RonAaron61/EIT-Microcontroller/assets/image/PCB_2D.png

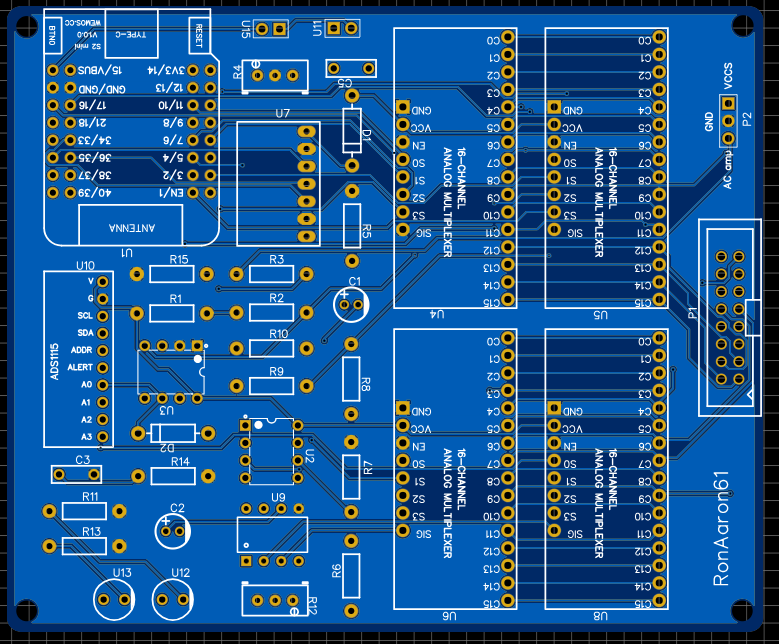
assets/image/PCB_2D.png
