RonAaron61/EIT-Microcontroller/assets/image/Result_Prototype_1/Result_3_30K.png

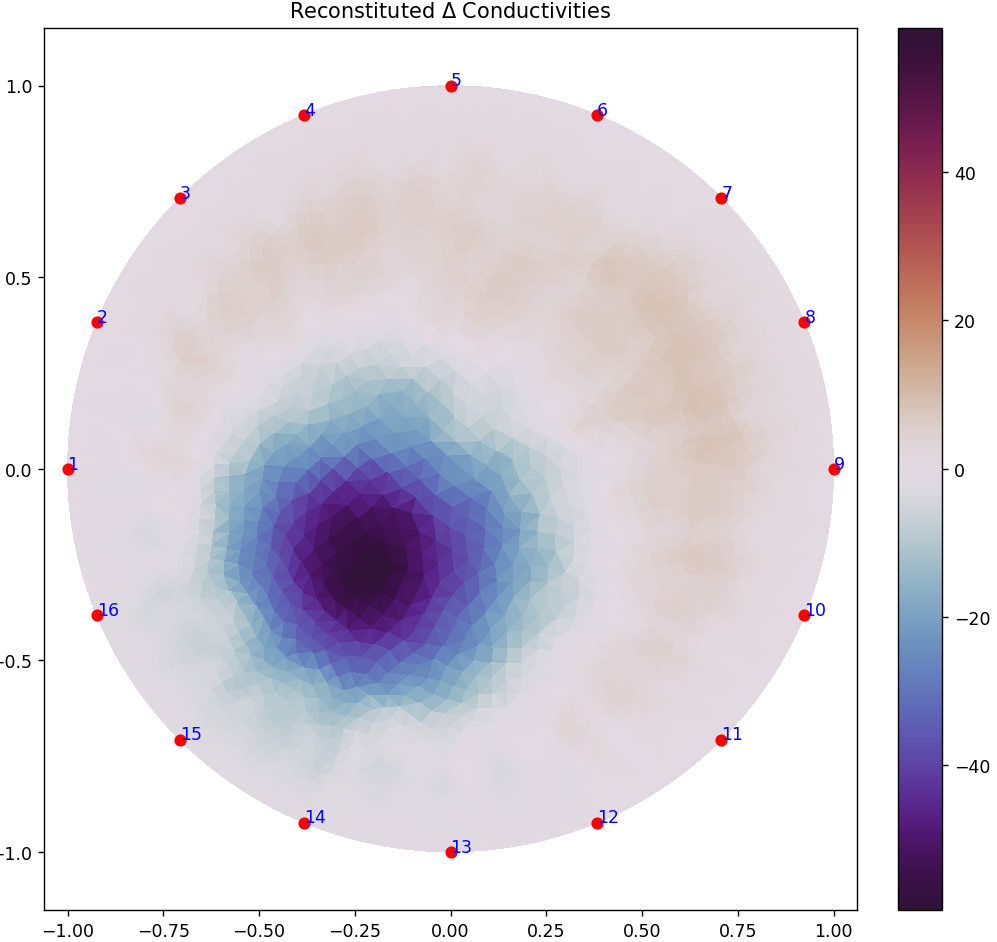
assets/image/Result_Prototype_1/Result_3_30K.png
