RonAaron61/EIT-Microcontroller/assets/image/Result_Prototype_1/Result_5_30K.png

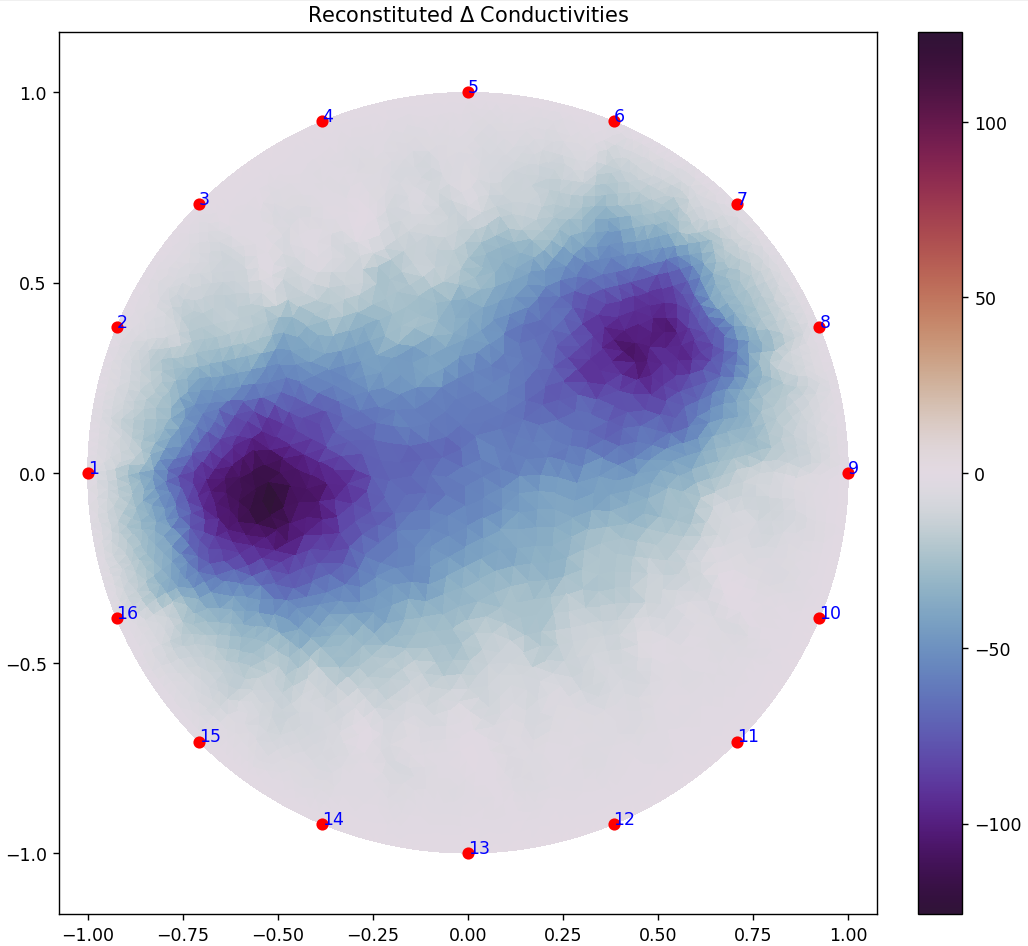
assets/image/Result_Prototype_1/Result_5_30K.png
