RonAaron61/EIT-Microcontroller/assets/image/Result_Prototype_1/Spidol_Elect 4-5_30k.png

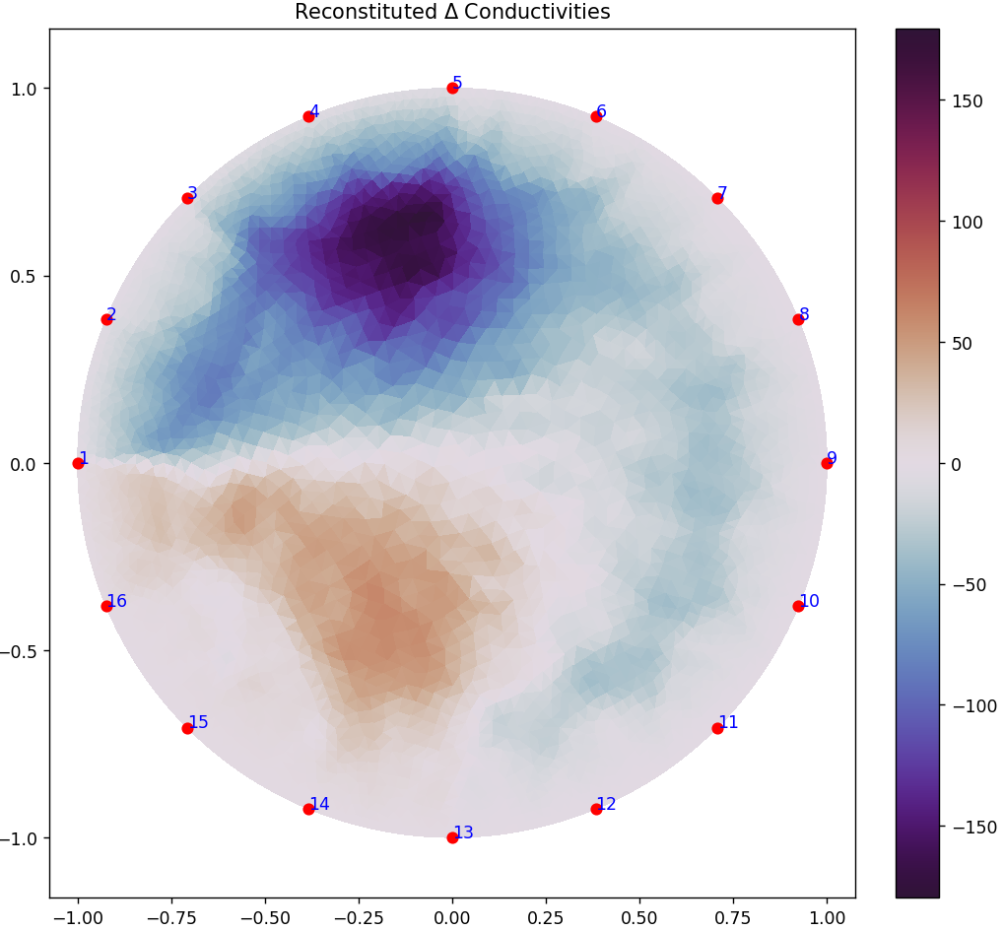
assets/image/Result_Prototype_1/Spidol_Elect 4-5_30k.png
