RonAaron61/EIT-Microcontroller/(threads)

Thread 1 (2024-05-28):

Request for Guidance on ESP32 S2 Microcontroller-Based Electrical Impedance Tomography Device

popular1119, 2024-05-28:
Dear RonAaron61,

I hope this message finds you well.

My name is Peng Piao, and I have been deeply inspired by your project on the ESP32 S2 microcontroller-based Electrical Impedance Tomography (EIT) device. I have thoroughly reviewed the materials and documentation you have shared on GitHub and am truly impressed by the innovation and technical expertise demonstrated in your work.

As someone who is passionate about electronics and microcontroller-based projects, I am particularly interested in understanding the thought process and methodology behind your project. While the documentation provides a comprehensive overview of the implementation, I am eager to learn more about the challenges you faced, the decisions you made, and the techniques you employed during the development of this device.

I would be immensely grateful if you could spare some time to share your insights and experiences with me. Specifically, I am interested in discussing:
1. The initial conceptualization and design phase of the project.
2. The selection process for the ESP32 S2 microcontroller and other key components.
3. Any significant challenges or obstacles you encountered and how you overcame them.
4. Best practices and tips for someone looking to embark on a similar project.

I believe that your guidance would be invaluable in helping me gain a deeper understanding of EIT technology and its practical applications. I am eager to learn from your experience and apply this knowledge to my own projects.

Thank you very much for considering my request. I look forward to the possibility of connecting with you and learning from your expertise.

Best regards,

Peng Piao
pengpiao1119@gmail.com

RonAaron61, 2024-05-28:
Hello Peng Piao,

I'm happy to have someone interested in my project.

First of all, about the conceptualization of the design, I got the concept because my undergraduate thesis is also about EIT, so I got the abstract design and the main concept of how it works from my lectures and other papers. Then I modified and implemented it on this project.

The reason why I chose the ESP is that it’s relatively cheap and has many pinouts. Because based on my design, it required at least 16 pins for the demultiplexer/multiplexer and another 5 pins for the AD9833 and ADS1115 modules, the integrated wifi module can also be useful if you want to make it wireless. For the other components, I looked for papers related to EIT and analyzed what type of components they used, so that I could use them.

After finding what components are suitable for my project then I can make a prototype of each circuit/component to see if it actually work. Then it can be combined into one functional protoype. At this time is when you need to solve any challenges, especially because when prototyping I used a proto-board and jumper wires, which made it look stressful, that is why I suggested making them one by one. Always double-check for the wire and pin connection, especially if it’s related to supply, the type of the IC may also affect the result. Also sometimes the problem is the one you least expect it.

I think it’s best to look for multiple papers/journals about EIT and see what components they use and try it by yourself, to find which is the most suitable for the project.

I'm welcome for related questions, but I may not be good at explaining, because I’m not really an expert in this field.

I hope this answers most of your questions,

Best,

Aaron

popular1119, 2024-05-29:
Hi Aaron,

Thank you very much for your previous response. I have a few more questions that I hope you can help me with:

Firstly, due to the geographical difference between us, there might be a time difference. Therefore, I may not be able to respond to your messages promptly, and I appreciate your understanding.

1. Purpose and Published Articles: Could you please share what your ESP32 S2 Electrical Impedance Tomography (EIT) device is primarily used to measure? Additionally, have you published any articles or papers about this device? If so, I would love to read them.

2. Lung Monitoring: Is your EIT device used for lung respiration monitoring? I have an EIT device here, but it does not work properly when used for lung respiration monitoring. Therefore, I hope to understand some relevant details.

3. Microcontroller and Chip Communication: I would like to learn more about the control and communication between microcontrollers and other chips. Although I use many devices, I do not know much about their internal principles. Do you have any recommended courses or resources that can help me better understand this area?

Thank you very much for your time and assistance. I look forward to your response.

Best regards,
Peng Piao
pengpiao1119@gmail.com

RonAaron61, 2024-05-29:
For now, I only use my project device for measuring objects (eq. plastic or metal) on the water solution phantom, like one of the images on the GitHub page. But maybe later I also want to test if it can detect anomalies (eq. cancer) in objects that have the same impedance as the human body, I have tried to make an agar phantom in my previous undergraduate project using the reference from [Bennet D. (2010)]( http://dx.doi.org/10.1016/j.msec.2010.08.018). But I also want to improve my device because I don’t know why, but when I tried to scan an object in the middle of the phantom it doesn’t show great.  For now, I haven’t published a paper or articles related to this project.

That is an interesting Idea to use it as a lung monitoring device. But I haven’t tried it to scan on the thorax area. Maybe it is related to the current being injected or the frequency being used? Because from what I know higher freq eq. ≥ 50kHz is more able to penetrate cells (?).

To be honest, I also don’t really know how the principles of the chip work, I only know how to use it and maybe some of the specifications based on its datasheet. If we speak maybe like the modules that I used, I think you can just search online on its pinout, and how to connect and code it to the microcontroller, I think there is a lot of websites or videos explaining it because most of it is open-source. Some of the modules used either I2C or SPI communication protocol, maybe you can look at it while trying the module itself.
When I find some interesting modules or IC I usually just search what is the pinouts and how to use them online, and then tried it myself.

Hope this help

Best,
Aaron

RonAaron61, 2024-05-30:
Hi Peng Piao,

I would say that it's not 100% guaranted, but building it one module at a time then gradually start adding another components while check if it still working can minimize the error, whilst if you doing it all at once, it would be difficult to identify which one is the problem, because you have to prob each pins to analyze it.

During the integration process because I usually use a project board with lots of jumper cables, maybe you can try simplify the cable connections so it doesn't get confusing or label the important cables like the output / input, because let say you have a break from the project for a couple of day, you would still know which cables is which. Also check the component specifications, because it is possible that the output of that component exceeds the input specifications of the next connected component, especially when dealing with gain. but I think because all components are connected to the same supply voltage, the possibility of this is low.

One of the most important things is to check what kind of output or input the component requires.

Then you also need to be careful when combining the coding of several modules into one final program.

Hope this help
Best,
Aaron

popular1119, 2024-05-30:
Dear Aaron,

I sincerely appreciate your patient responses. They have been incredibly helpful to me.

Moving forward, I will begin working on creating the Electrical Impedance Tomography (EIT) device. As I proceed, I hope to be able to reach out to you for guidance if I encounter any issues.

Thank you once again for your support!

Best regards,

Peng Piao

RonAaron61, 2024-05-30:
Hi Peng Piao

Of course, anytime, I am happy to help. I hope your project goes as smoothly as you planned. Goodluck

Best Regards,
Aaron

Thread 2 (2024-07-04):

Assistance Required for EIT Boundary Voltage Signal Processing and Frame Rate Improvement

popular1119, 2024-07-04:
Hi Aaron,

I hope this message finds you well. I have a couple of technical questions regarding electrical impedance tomography (EIT) that I hope you can help with.

First, after the boundary voltage analog signal is selected through the multiplexer and amplified, it is sent to the analog-to-digital converter (ADC). Is there any special processing, aside from filtering, that needs to be done to the boundary voltage analog signal before converting it to a digital signal? Or can we directly convert the analog signal to a digital signal and then send it to the microcontroller for further conversion back to an analog signal without any special processing?

Additionally, I am looking to improve the acquisition rate to around 100 frames per second. Could you please advise on the best approach to achieve this?

Thank you very much for your help!

Best regards,
Peng Piao

RonAaron61, 2024-07-05:
Hi Peng Piao,

Hmm, I’m assuming that you want to read the Max/rms voltage, if so based on my previous project I think you should check the capability of your ADC first because if you directly input an analog AC signal into the ADC it may destroy the module, because the ADC may not be capable of reading a negative voltage, and even if the ADC can read negative voltage I think the readout may fluctuate between the max voltage and min voltage (assumed the signal is an AC signal). I think you can change the AC signal to a DC signal first then connect it to your ADC.

As for the acquisition rate, I also don't really know about this, but I think it is related to the controller's processing speed and how well/optimized the code is written.

Hope this help

Best regards,
Aaron

popular1119, 2024-07-06:
Aaron,

I'm not sure why, but the sine wave signal output from my AD9833 measures at an amplitude of 6V. I tried using the AD8421 and the programmable AD5270 to adjust the amplitude, but it had no effect and instead caused the waveform to become distorted.

Thanks!

Peng Piao

popular1119, 2024-07-06:
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
The first one is the waveform directly output by AD9833, and the second photo is after adjustment.

RonAaron61, 2024-07-06:
Hi Peng Piao,

Hmm, that's interesting, from what I read the output of AD9833 usually maxs at around 600mV, isn't the sine wave around 2.12Vpp in the image?, and so the problem is when you want to change the amplitude from the AD9833 it becomes distorted. I assumed you connected the output of AD9833 directly into AD8421 (which is an instrument amplifier) and controlled the gain using AD5270 (is it a digital potentiometer?). I never use AD8421 but I think it is similar to what I used before which is AD620. Do you connect the output of AD9833 to the Positive input of AD8421 and the Negative input & REF to GND? or do you have another configuration? because an Instrument amplifier amplifies the difference between the negative and positive input. Or maybe try adding a buffer between the output of AD9833 and AD8421 (?)
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
another alternative is using a non-inverting amplifier to amplify the signal

Aaron

popular1119, 2024-07-08:
Hi Aaron，

I checked the relevant information and found that the output of AD9833 is between 0.4~0.6V. I don’t know why it is so high here.

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

Peng Piao

RonAaron61, 2024-07-09:
Hi Peng Piao,

Have you found a solution to it? I have tried to make a similar circuit but for the Instrument amplifier I used AD620 and regular trimpot, and the result was also not very great, but my AD9833 output is only around 0.5V either with 3.3V or 5V, and I don’t really know what caused the output to be so high.

As for the Instrument amplifier output, I've tried fiddling with the circuit like offsetting the input and -IN by 2.5V (the same with ref), adding buffer, changing the Instrument Amplifier by a non-inverting amp (single rail supply), etc. and it still doesn't work, but you may try messing with it maybe it somehow works on yours. My only answer for now is to try to use a dual rail supply (eq. +5V and -5V) on the Instrument amplifier.

Aaron

popular1119, 2024-07-11:
Hi Aaron,

I still don't know why, so I'm going to buy a new AD9833 module and try it again.

Peng Piao

popular1119, 2024-08-02:
Hi Aaron,

Long time no contact, hope everything is well. I read your code today. It seems that your code directly reads the collected voltage value without any additional operations, because I saw that some people seem to calculate the amplitude and average of the read voltage value. Square root and phase. Your code does not operate in this way, which means that the voltage value read directly can be used for imaging, right?

Peng Piao

RonAaron61, 2024-08-27:
Hello Peng Piao,

I'm so sorry for the long response. I'm doing well just been a busy month, I hope everything went well with you also.

Yeah, I directly use the voltage value from the ADC (that I later knew somehow my ADC value offset by around 17%). I initially wanted to read the phase but I think I need another module to read it. As for the other like average and square root or maybe square mean root (rms) I think the result would be similar, maybe reading the average would remove some of the noise (?). And also the reason why I don't do any processing is to speed up the reconstruction and gathering data. Maybe you can experiment with it to see which method can result the best within the desired time.

Best Regards,
Aaron

Thread 3 (2025-03-11):

Request for Guidance on the Signal captured by the EIT device using ESP32 S3 Dev Kit

mrana47, 2025-03-11:
Dear Aaron,
I hope this email finds you well.

I have been following your ESP32 S2 Electrical Impedance Tomography (EIT) project on GitHub with great interest. I saw you video and circuits that are truly inspiring. I am also working on the same module. I followed your circuit. I divided the circuit into two part. One is before adding MUX and rest.
I found that after applying 30 kHz sine signal in AD9833, I am getting correct signal. Then add the four MUX to build the complete circuit. After finishing the circuit. I made the following phantom setup. But I am not getting the signal you got as a homogenous sample. Could you please help me regarding this. Is there anything wrong in the setup. I made the circuit exactly same you made, only difference is that I used ESP32 S3 Dev kit instead of  WEMOS S2 Mini.
I have add the pictures.

Thanks
Masud

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

RonAaron61, 2025-03-12:
Hello Masud,

Thank you for the message. I see. Does the 30 kHz that you read after the AD9833 or after the amplifier/VCCS? Can you try reading the signal on the 'one before adding MUX' circuit like the image below? If all the signals are good, then I can say that the circuit is good, and the power is also running, especially the positive and negative voltage (because that was also my problem when starting this project). Or you can do it with the MUX circuit.

I'm thinking of one of this may be your problem based on my experience:
- The positive and Negative voltage is not stable ( it should be at least +3.3V and -3.3V so that the IC is running).
- What type of IC are you using, some OP-Amp ICs can't handle high-frequency
- and also check if each component/IC/module is working
- Because you're using a different ESP, are the pins on the correct pins?
- Try to do a calibration first:
  1. Set the MUX to one pin (or like the calibrate button)
  2. Try reading the signal before it goes to the MUX and Phantom (after the VCCS) if the amplifier is too high the signal may collapse because is higher than the input voltage of the IC
  3.  Then also try reading the signal after the Phantom Mux, it should be on the same frequency as the input
  4. Check the output of the Instrument Amplifier, same as VCCS, if the Gain is too High the signal may also collapse, try moving the potentiometer to the Minimum/max to see the range
  5. Lastly if all check out, It may be because of the AC to DC reading

- try using a resistor first like the image below just to make sure,
- It could also just be the bad cable or some IC not working, this also happened to me sometimes

Also in this project to get the negative voltage I used the voltage divider but it requires you to input a voltage twice the voltage you need, you could also use a positive-to-negative module and connect it to the input voltage of the ESP (the BUS pin) so you don't need additional power input. I use this on the next version of this project, although it doesn't improve much besides a more compact size, Link: https://github.com/RonAaron61/MyEIT-V1.1

Hope this message helpful

Best regards,
Aaron

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

mrana47, 2025-03-14:
Dear Aaron,
Thank you very much for your reply. I saw your new project. I want to build that project. I just wondering, can you please share the component that you used to make.

Best Regards
Masud

RonAaron61, 2025-03-17:
Hello Masud,
it basically has the same circuit with some minor change, and the change from DIP to SMD components, but you can see the components and the circuit on the assets/PCB folder, the one that are pdf file.

Best Regards,
Aaron

mrana47, 2025-03-17:
Hi Aaron,
Thank you very much for your reply. In the PCB pdf file I saw there is a component that mentioned as RN1 and RN2 with six pin. I am not sure about this component. And you used CA3240E amplifier instated of OPA2134 PA. Do i need to use the CA3240E one or I can use the previous one.

Thanks
Masud

RonAaron61, 2025-03-18:
Hello Masud,

Ah sorry, I think I sent the wrong version of the schematic, the RN2 is supposed to be 1kΩ resistor array, and the RN1 is 10kΩ resistor array. I think I missed the schematic file and only save the old version. It supposed to look like the image below (except the capacitor on -Vin and +Vin).
For the op-amp, it basically has the same function. I primary use the opa2134, but CA3240E also work fine as long as the I/O pin is the same. It just an alternative IC, maybe if you want to replace it with a more cheaper/ stronger IC.

Hope this help.

Best regard,
Aaron

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

mrana47, 2025-03-18:
HI Aaron,
Thank you very much for your reply.
I was able to get good signal from arus output.
But now I am facing a challenge about the I2C communication.

Wire.begin(SDA, SCL);
  ads.setGain(GAIN_ONE);  // 1x gain  +/- 4.096V  1 bit = 0.125mV
  if (!ads.begin())
  {
    while (1){
      Serial.println("Failed to initialize ADS.");
    }
  }
This part of the code is not running.
Its seems like ads is not initialized.
Do know what kind of problem it is.

RonAaron61, 2025-03-20:
Hi Masud

Are you using the same library for the ada?. And also have you check the wiring? Especially for the SDA&SCL pin?
. If the wiring are correct, maybe try running the example code from the library.

Regards,
Aaron

mrana47, 2025-04-28:
Hi Aaron,
Can I get your email address?
Thanks
Masud

RonAaron61, 2025-05-01:
Yeah, you can email me at valaaron061@gmail.com

Aaron
