RonAaron61/EIT-Microcontroller/(commit log)

2023-12-10 Add Protoype Code
    Adding Prototype Code for future need
2024-01-31 Schematic Update
2024-01-31 Schematic Update and fix
2024-02-12 Update README.md
    PCB added
2024-02-20 Add the ArduinoC program version
